Wren6991/PiBook/Readme.md

PiBook
======

Mini Raspberry Pi Compute Module-based laptop.

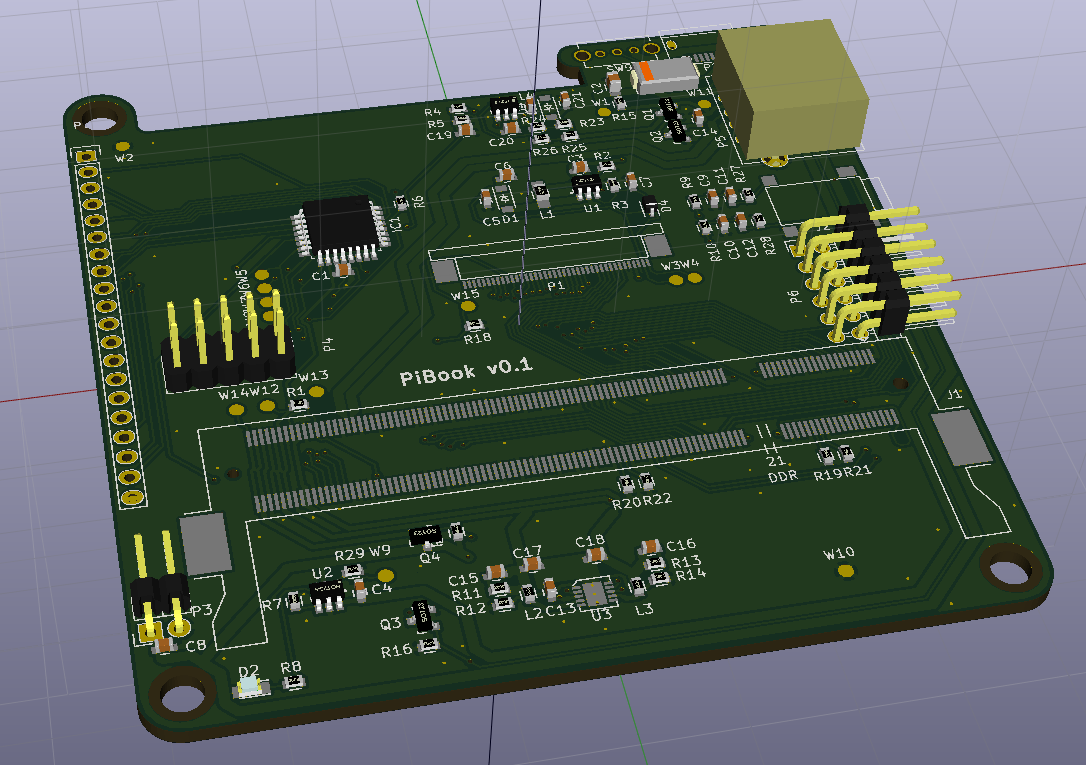
[picture p1: img/board_3d_view.png]


Unless stated otherwise (e.g. the contents of datasheets/) the contents of this repository is distributed under the revised BSD licence; see LICENSE.txt.
