Wren6991/PiBook/case/001.JPG

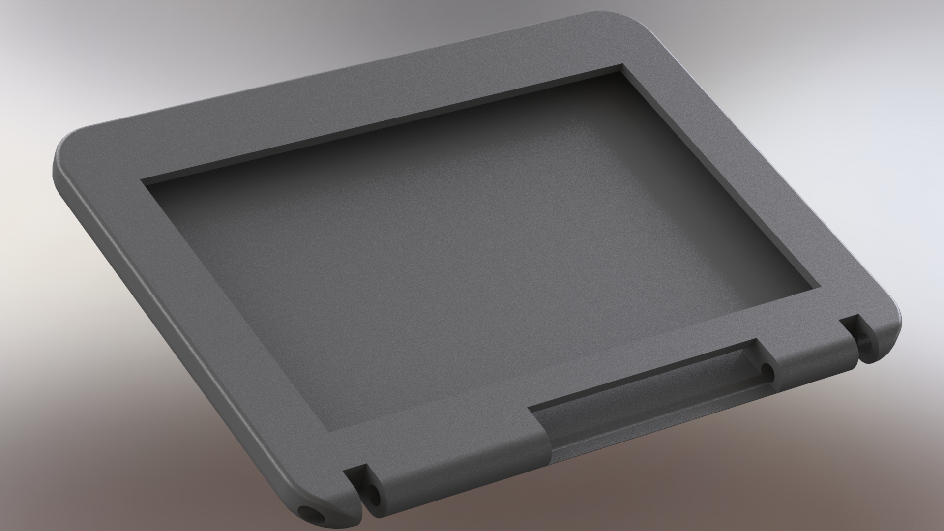
case/001.JPG
