Wren6991/PiBook/case/002.JPG

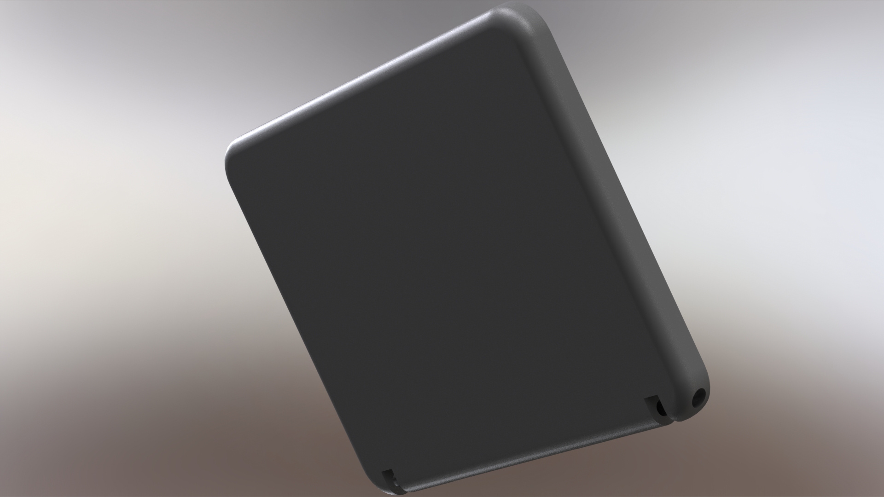
case/002.JPG
