Wren6991/PiBook/case/003.JPG

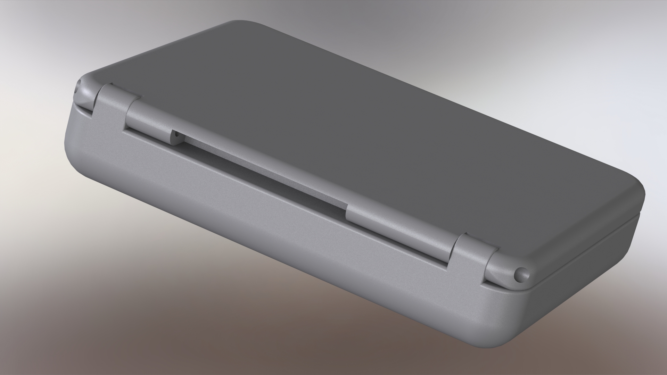
case/003.JPG
