Wren6991/PiBook/case/004.JPG

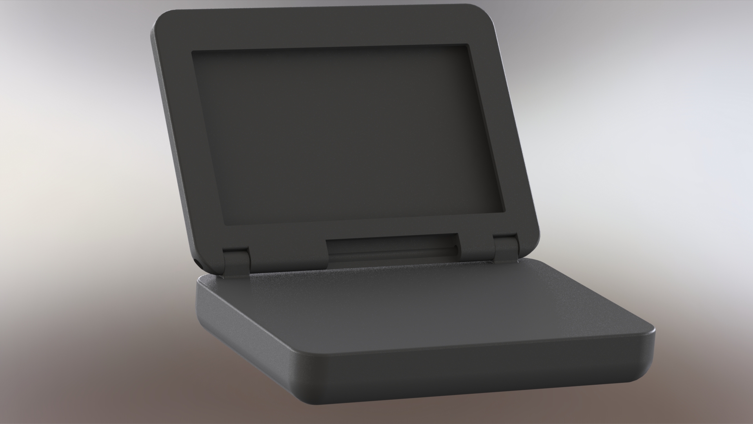
case/004.JPG
