Wren6991/PiBook/case/005.JPG

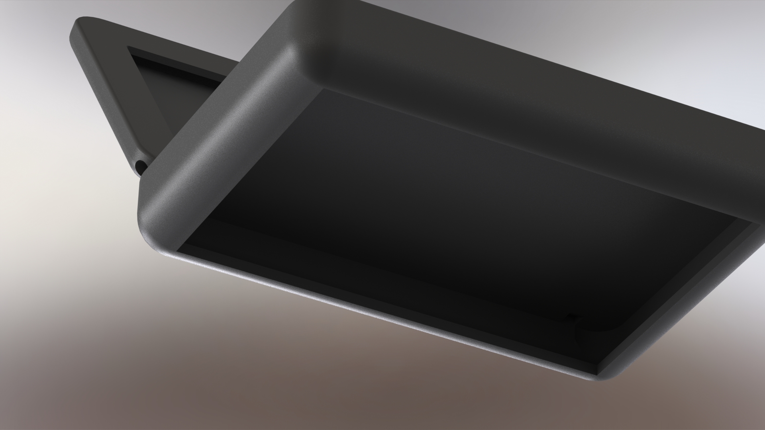
case/005.JPG
