Wren6991/PiBook/datasheets/DPI Connection table.png

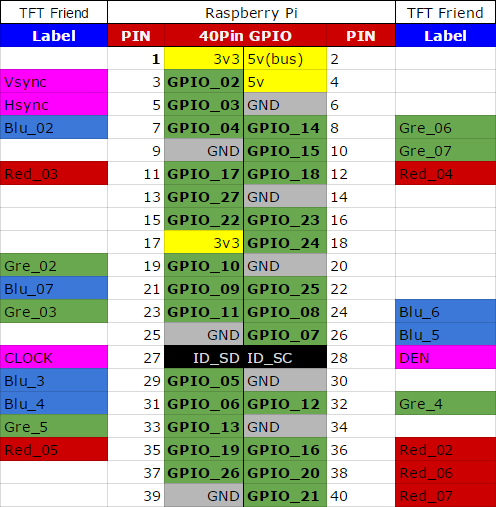
datasheets/DPI Connection table.png
