Wren6991/PiBook/pibook.pdf

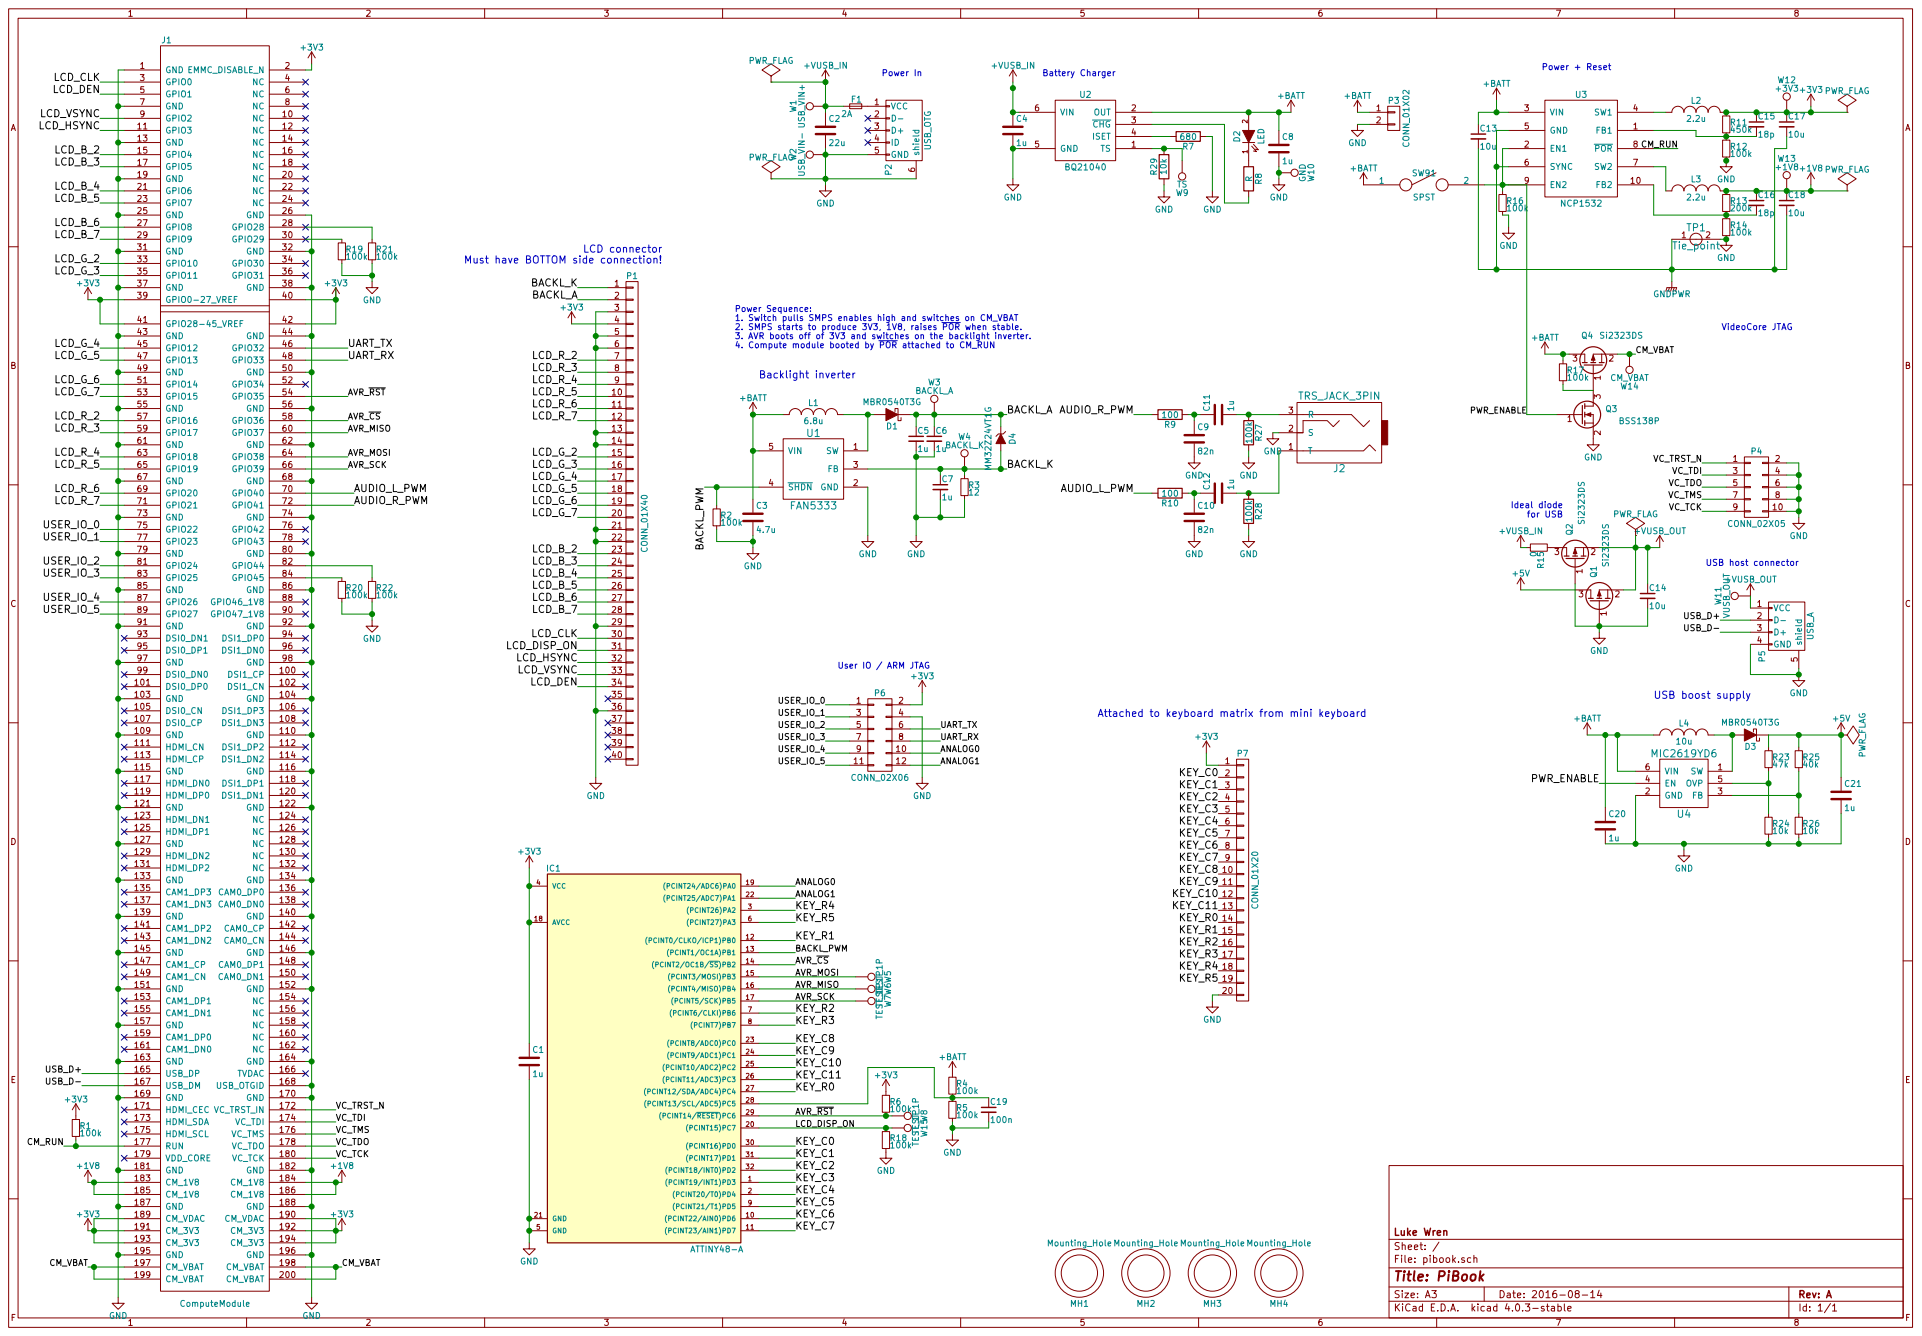
[picture p8: page 1]

Must have BOTTOM side connection!

1. Switch pulls SMPS enables high and switches on CM_VBAT
2. SMPS starts to produce 3V3, 1V8, raises POR when stable.
3. AVR boots off of 3V3 and switches on the backlight inverter.
4. Compute module booted by POR attached to CM_RUN

File: pibook.sch Sheet: / Luke Wren
