Wren6991/PiBook/pibook.kicad_pcb

## KiCad design pibook.kicad_pcb (2016-11-02)

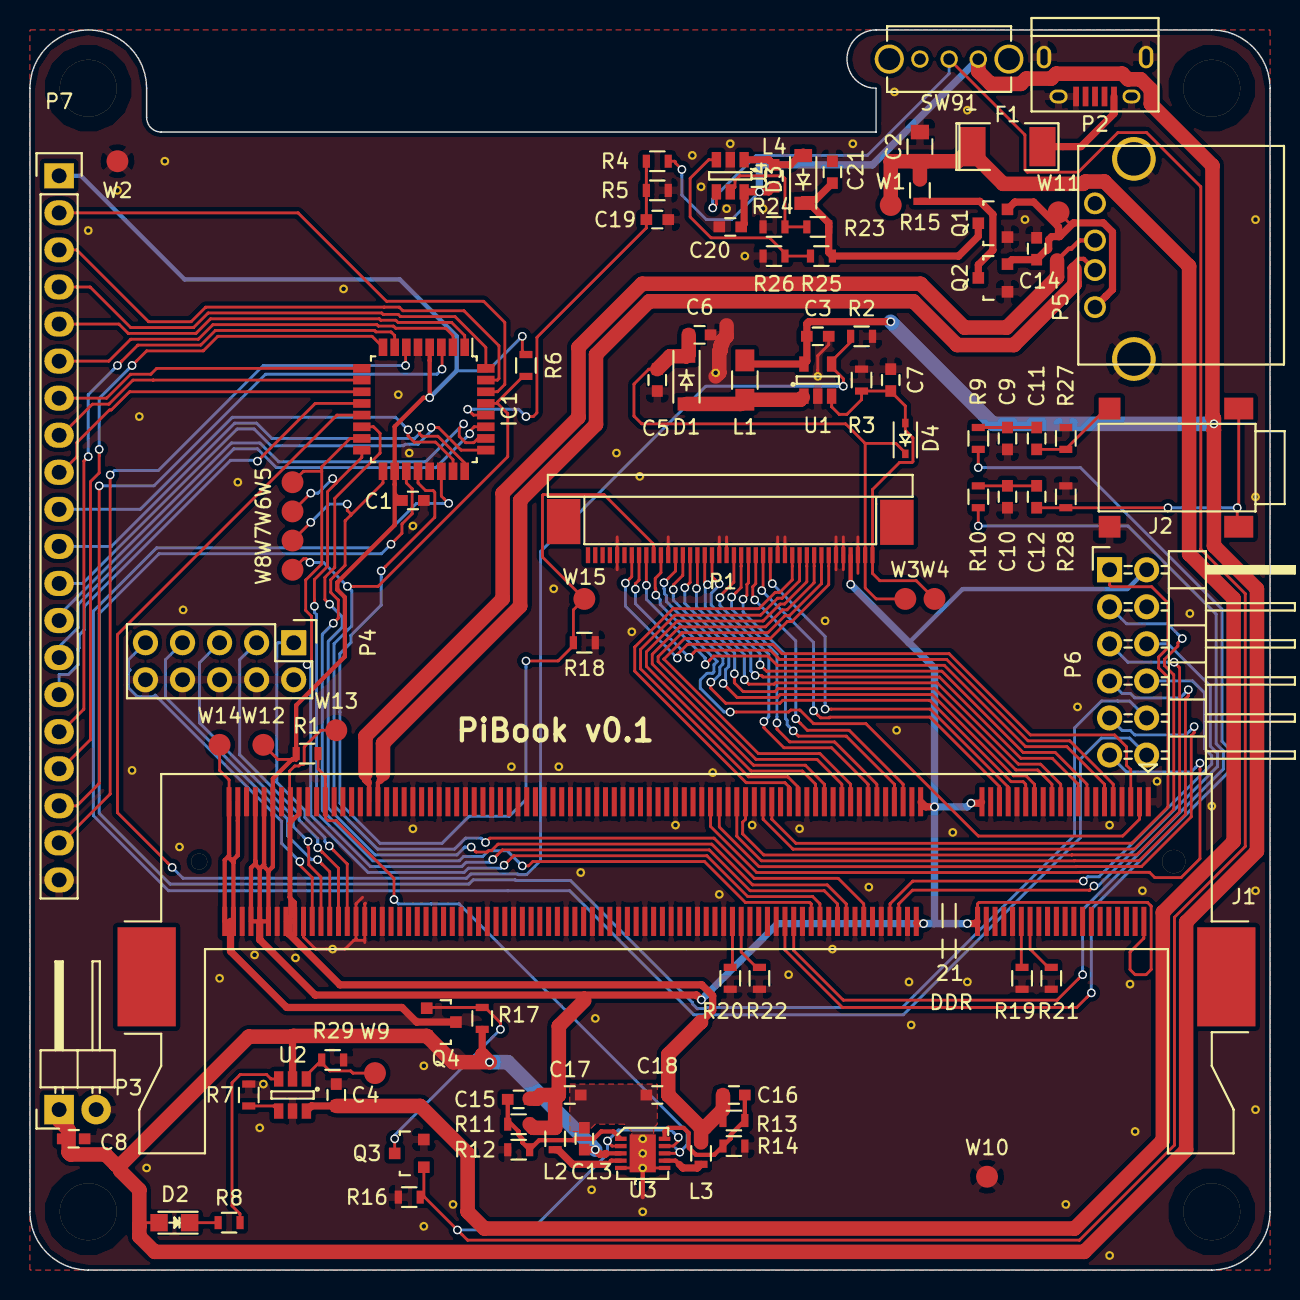
[picture p9: board pibook.kicad_pcb from above]

Board: 2 copper layers, 85.0 x 85.0 mm, 98 parts (0 on the bottom side), 103 nets.

Parts:
C1, C4, C5, C6, C7, C8, C11, C12, C20, C21: 1u; C_0603
C2: 22u; C_0805
C3: 4.7u; C_0603
C9, C10: 82n; C_0603
C13, C14, C17, C18: 10u; C_0603
C15, C16: 18p; C_0603
C19: 100n; C_0603
D1, D3: MBR0540T3G; SOD-123
D2: LED; LED_0805
D4: MM32Z24VT1G; SOD-323
F1: 2A; SMD-2010_Pol
IC1: ATTINY48-A; LQFP-32_7x7mm_Pitch0.8mm
J1: ComputeModule; Socket_SODIMM_DDR1-2_TE_1612618
J2: TRS_JACK_3PIN; TRS_3_SMD
L1: 6.8u; R_0805_HandSoldering
L2, L3: 2.2u; R_0603
L4: 10u; C_0603
MH1, MH2, MH3, MH4: Mounting_Hole; Mounting_hole_M3.5
P1: CONN_01X40; FPC40_BOTTOM
P2: USB_OTG; USB_Micro-B
P3: CONN_01X02; Pin_Header_Angled_1x02
P4: CONN_02X05; Pin_Header_Straight_2x05
P5: USB_A
P6: CONN_02X06; Pin_Header_Angled_2x06
P7: CONN_01X20; Pin_Header_Straight_1x20
Q1, Q2, Q4: Si2323DS; SOT-23
Q3: BSS138P; SOT-23
R1, R2, R4, R5, R6, R12, R14, R16, R17, R18, R19, R20, R21, R22, R27, R28: 100k; R_0603
R3: 12; R_0603
R7: 680; R_0603
R8: R; R_0603
R9, R10: 100; R_0603
R11: 450k; R_0603
R13: 200k; R_0603
R15: 0; R_0603
R23: 47k; R_0603
R24, R26, R29: 10k; R_0603
R25: 40k; R_0603
SW91: SPST; SPDT_SLIDE_SWITCH
TP1: Tie_point; tiepoint-0.3
U1: FAN5333; SOT-23-5
U2: BQ21040; SOT-23-6
U3: NCP1532; UDFN-10
U4: MIC2619YD6; SOT-23-6
W1: USB_VIN+; Measurement_Point_Round-SMD-Pad_Small
W2: USB_VIN-; Measurement_Point_Round-SMD-Pad_Small
W3: BACKL_A; Measurement_Point_Round-SMD-Pad_Small
W4: BACKL_K; Measurement_Point_Round-SMD-Pad_Small
W5, W6, W7, W8, W15: TEST_1P; Measurement_Point_Round-SMD-Pad_Small
W9: TS; Measurement_Point_Round-SMD-Pad_Small
W10: GND; Measurement_Point_Round-SMD-Pad_Small
W11: VUSB_OUT; Measurement_Point_Round-SMD-Pad_Small
W12: +3V3; Measurement_Point_Round-SMD-Pad_Small
W13: +1V8; Measurement_Point_Round-SMD-Pad_Small
W14: CM_VBAT; Measurement_Point_Round-SMD-Pad_Small

Connections:
+1V8: C16.1, C18.1, J1.183, J1.184, J1.185, J1.186, L3.2, R13.1, W13.1
+3V3: C1.1, C15.1, C17.1, IC1.4, IC1.18, J1.2, J1.39, J1.40, J1.41, J1.42, J1.189, J1.190, J1.191, J1.192, J1.193, J1.194, L2.2, P1.4, P6.2, P7.1, R1.1, R6.1, R11.1, W12.1
+5V: C21.1, D3.1, Q1.3, R23.1, R25.1
+BATT: C3.1, C8.1, C13.1, C20.1, D2.2, L1.1, L4.1, P3.1, Q4.2, R4.1, R17.1, SW91.1, U1.5, U2.2, U3.3, U4.6
+VUSB_IN: C2.1, C4.1, F1.1, R15.2, U2.6, W1.1
+VUSB_OUT: C14.1, P5.1, Q1.2, Q2.2, W11.1
/ANALOG0: IC1.19, P6.10
/ANALOG1: IC1.22, P6.12
/AUDIO_L_PWM: J1.70, R10.2
/AUDIO_R_PWM: J1.72, R9.2
/AVR_MISO: IC1.16, J1.60, W6.1
/AVR_MOSI: IC1.15, J1.64, W5.1
/AVR_SCK: IC1.17, J1.66, W7.1
/AVR_~CS: IC1.14, J1.58
/AVR_~RST: IC1.29, J1.54, R6.2, W8.1
/BACKL_A: C5.1, C6.1, D1.1, D4.1, P1.2, W3.1
/BACKL_K: C7.1, D4.2, P1.1, R3.1, U1.3, W4.1
/BACKL_PWM: IC1.13, R2.1, U1.4
/CM_RUN: J1.177, R1.2, U3.8
/CM_VBAT: J1.197, J1.198, J1.199, J1.200, Q4.3, W14.1
/KEY_C0: IC1.30, P7.2
/KEY_C1: IC1.31, P7.3
/KEY_C2: IC1.32, P7.4
/KEY_C3: IC1.1, P7.5
/KEY_C4: IC1.2, P7.6
/KEY_C5: IC1.9, P7.7
/KEY_C6: IC1.10, P7.8
/KEY_C7: IC1.11, P7.9
/KEY_C8: IC1.23, P7.10
/KEY_C9: IC1.24, P7.11
/KEY_C10: IC1.25, P7.12
/KEY_C11: IC1.26, P7.13
/KEY_R0: IC1.27, P7.14
/KEY_R1: IC1.12, P7.15
/KEY_R2: IC1.7, P7.16
/KEY_R3: IC1.8, P7.17
/KEY_R4: IC1.3, P7.18
/KEY_R5: IC1.6, P7.19
/LCD_B_2: J1.15, P1.23
/LCD_B_3: J1.17, P1.24
/LCD_B_4: J1.21, P1.25
/LCD_B_5: J1.23, P1.26
/LCD_B_6: J1.27, P1.27
/LCD_B_7: J1.29, P1.28
/LCD_CLK: J1.3, P1.30
/LCD_DEN: J1.5, P1.34
/LCD_DISP_ON: IC1.20, P1.31, R18.1, W15.1
/LCD_G_2: J1.33, P1.15
/LCD_G_3: J1.35, P1.16
/LCD_G_4: J1.45, P1.17
/LCD_G_5: J1.47, P1.18
/LCD_G_6: J1.51, P1.19
/LCD_G_7: J1.53, P1.20
/LCD_HSYNC: J1.11, P1.32
/LCD_R_2: J1.57, P1.7
/LCD_R_3: J1.59, P1.8
/LCD_R_4: J1.63, P1.9
/LCD_R_5: J1.65, P1.10
/LCD_R_6: J1.69, P1.11
/LCD_R_7: J1.71, P1.12
/LCD_VSYNC: J1.9, P1.33
/PWR_ENABLE: Q3.1, R16.1, SW91.2, U3.2, U3.9, U4.4
/UART_RX: J1.48, P6.8
/UART_TX: J1.46, P6.6
/USB_D+: J1.165, P5.2
/USB_D-: J1.167, P5.3
/USER_IO_0: J1.75, P6.1
/USER_IO_1: J1.77, P6.3
/USER_IO_2: J1.81, P6.5
/USER_IO_3: J1.83, P6.7
/USER_IO_4: J1.87, P6.9
/USER_IO_5: J1.89, P6.11
/VC_TCK: J1.180, P4.9
/VC_TDI: J1.174, P4.3
/VC_TDO: J1.178, P4.5
/VC_TMS: J1.176, P4.7
/VC_TRST_N: J1.172, P4.1
GND: C1.2, C2.2, C3.2, C4.2, C5.2, C6.2, C7.2, C8.2, C9.2, C10.2, C14.2, C19.2, C20.2, C21.2, IC1.5, IC1.21, J1.1, J1.7, J1.13, J1.19, J1.25, J1.26, J1.31, J1.32, J1.37, J1.38, J1.43, J1.44, J1.49, J1.50, J1.55, J1.56, J1.61, J1.62, J1.67, J1.68, J1.73, J1.74, J1.79, J1.80, J1.85, J1.86, J1.91, J1.92, J1.97, J1.98, J1.103, J1.104, J1.109, J1.110, J1.115, J1.116, J1.121, J1.122, J1.127, J1.133, J1.134, J1.139, J1.140, J1.145, J1.146, J1.151, J1.152, J1.157, J1.163, J1.164, J1.168, J1.169, J1.170, J1.181, J1.182, J1.187, J1.188, J1.195, J1.196, J2.2, P1.3, P1.5, P1.6, P1.13, P1.14, P1.21, P1.22, P1.29, P1.36, P2.5, P2.6, P3.2, P4.2, P4.4, P4.6, P4.8, P4.10, P5.4, P5.5, P6.4, P7.20, Q1.1, Q2.1, Q3.2, R2.2, R3.2, R5.2, R7.1, R12.2, R14.2, R16.2, R18.2, R19.2, R20.2, R21.2, R22.2, R24.2, R26.2, R27.2, R28.2, R29.1, TP1.2, U1.2, U2.5, U4.2, W2.1, W10.1
GNDPWR: C13.2, C17.2, C18.2, TP1.1, U3.5, U3.6
unnamed: C10.1, C12.1, R10.1
unnamed: C9.1, C11.1, R9.1
unnamed: C11.2, J2.3, R27.1
unnamed: C12.2, J2.1, R28.1
unnamed: C15.2, R11.2, R12.1, U3.1
unnamed: C16.2, R13.2, R14.1, U3.10
unnamed: C19.1, IC1.28, R4.2, R5.1
unnamed: D1.2, L1.2, U1.1
unnamed: D2.1, R8.1
unnamed: D3.2, L4.2, U4.1
unnamed: F1.2, P2.1
unnamed: J1.28, R21.1
unnamed: J1.30, R19.1
unnamed: J1.82, R22.1
unnamed: J1.84, R20.1
unnamed: L2.1, U3.4
unnamed: L3.1, U3.7
unnamed: Q2.3, R15.1
unnamed: Q3.3, Q4.1, R17.2
unnamed: R7.2, U2.4
unnamed: R8.2, U2.3
unnamed: R23.2, R24.1, U4.5
unnamed: R25.2, R26.1, U4.3
unnamed: R29.2, U2.1, W9.1
