Wren6991/PiBook/datasheets/lcd_breakout.brd

## EAGLE design datasheets/lcd_breakout.brd (2016-08-14)

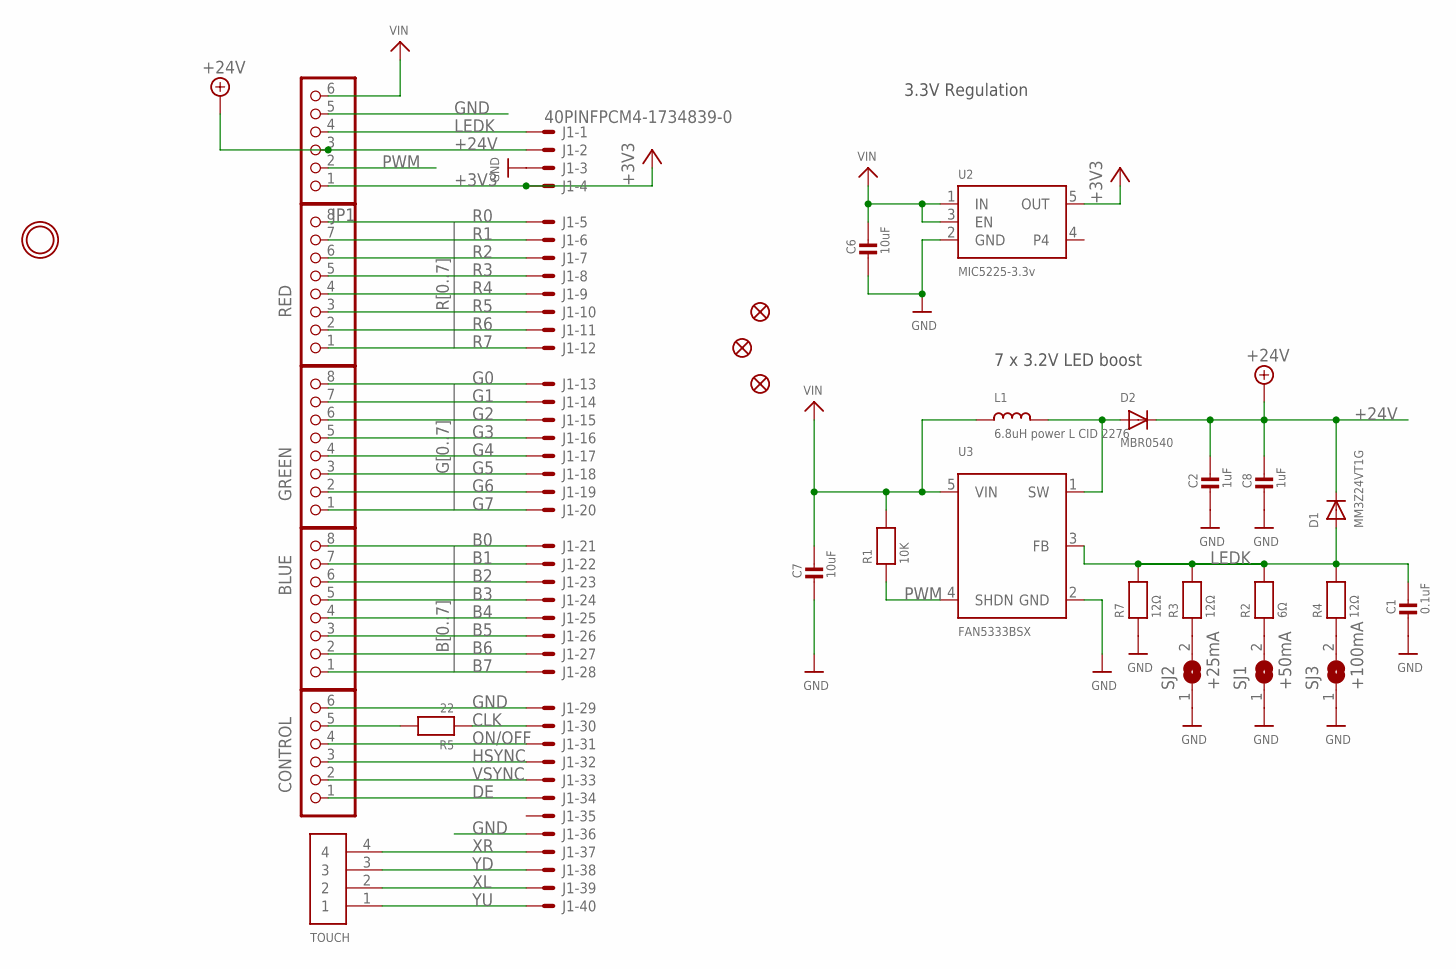
[picture p10: schematic lcd_breakout.sch]

Parts:
BLUE: PINHD-1X8BIG; 1X08-BIG
C1: 0.1uF; _0805MP
C2, C8: 1uF; _0805MP
C6, C7: 10uF; _0805MP
CONTROL: PINHD-1X6B; 1X06-BIG
D1: MM3Z24VT1G; SMADIODE
D2: MBR0540; SOD-123
FID1, FID2, FID3: FIDUCIAL""; FIDUCIAL_1MM
GREEN: PINHD-1X8BIG; 1X08-BIG
J1: 40PINFPCM4-1734839-0; 4-1734839-0
JP1: PINHD-1X6B; 1X06-BIG
L1: 6.8uH power L CID 2276; INDUCTOR_5X5MM_NR5040_NOTHERMALS
R1: 10K; _0805MP
R2: 6Ω; _0805MP
R3, R4, R7: 12Ω; _0805MP
R5: 22; _0805MP
RED: PINHD-1X8BIG; 1X08-BIG
SJ1: +50mA; SOLDERJUMPER_ARROW_NOPASTE
SJ2: +25mA; SOLDERJUMPER_ARROW_NOPASTE
SJ3: +100mA; SOLDERJUMPER_ARROW_NOPASTE
TOUCH: 1X4-BIG; 1X04-BIG
U2: MIC5225-3.3v; SOT23-5
U3: FAN5333BSX; SOT23-5@1
U$7: MOUNTINGHOLE2.5; MOUNTINGHOLE_2.5_PLATED

Connections:
+3V3: J1.4 (MS), JP1.1, U2.5 (OUT)
+24V: C2.1, C8.1, D1.C, D2.C, J1.2 (MS), JP1.3
B0: BLUE.8, J1.21 (MS)
B1: BLUE.7, J1.22 (MS)
B2: BLUE.6, J1.23 (MS)
B3: BLUE.5, J1.24 (MS)
B4: BLUE.4, J1.25 (MS)
B5: BLUE.3, J1.26 (MS)
B6: BLUE.2, J1.27 (MS)
B7: BLUE.1, J1.28 (MS)
CLK: J1.30 (MS), R5.1
DE: CONTROL.1, J1.34 (MS)
G0: GREEN.8, J1.13 (MS)
G1: GREEN.7, J1.14 (MS)
G2: GREEN.6, J1.15 (MS)
G3: GREEN.5, J1.16 (MS)
G4: GREEN.4, J1.17 (MS)
G5: GREEN.3, J1.18 (MS)
G6: GREEN.2, J1.19 (MS)
G7: GREEN.1, J1.20 (MS)
GND: C1.2, C2.2, C6.2, C7.2, C8.2, CONTROL.6, J1.3 (MS), J1.29 (MS), J1.36 (MS), JP1.5, R7.1, SJ1.1, SJ2.1, SJ3.1, U2.2 (GND), U3.2 (GND)
HSYNC: CONTROL.3, J1.32 (MS)
LEDK: C1.1, D1.A, J1.1 (MSV), JP1.4, R2.2, R3.2, R4.2, R7.2, U3.3 (FB)
unnamed: R2.1, SJ1.2
unnamed: R3.1, SJ2.2
unnamed: R4.1, SJ3.2
unnamed: CONTROL.5, R5.2
unnamed: D2.A, L1.P$2 (2), U3.1 (SW)
ON/OFF: CONTROL.4, J1.31 (MS)
PWM: JP1.2, R1.1, U3.4 (SHDN)
R0: J1.5 (MS), RED.8
R1: J1.6 (MS), RED.7
R2: J1.7 (MS), RED.6
R3: J1.8 (MS), RED.5
R4: J1.9 (MS), RED.4
R5: J1.10 (MS), RED.3
R6: J1.11 (MS), RED.2
R7: J1.12 (MS), RED.1
VIN: C6.1, C7.1, JP1.6, L1.P$1 (1), R1.2, U2.1 (IN), U2.3 (EN), U3.5 (VIN)
VSYNC: CONTROL.2, J1.33 (MS)
XL: J1.39 (MS), TOUCH.2
XR: J1.37 (MS), TOUCH.4
YD: J1.38 (MS), TOUCH.3
YU: J1.40 (MS), TOUCH.1

Notes on the sheet:
7 x 3.2V LED boost
3.3V Regulation

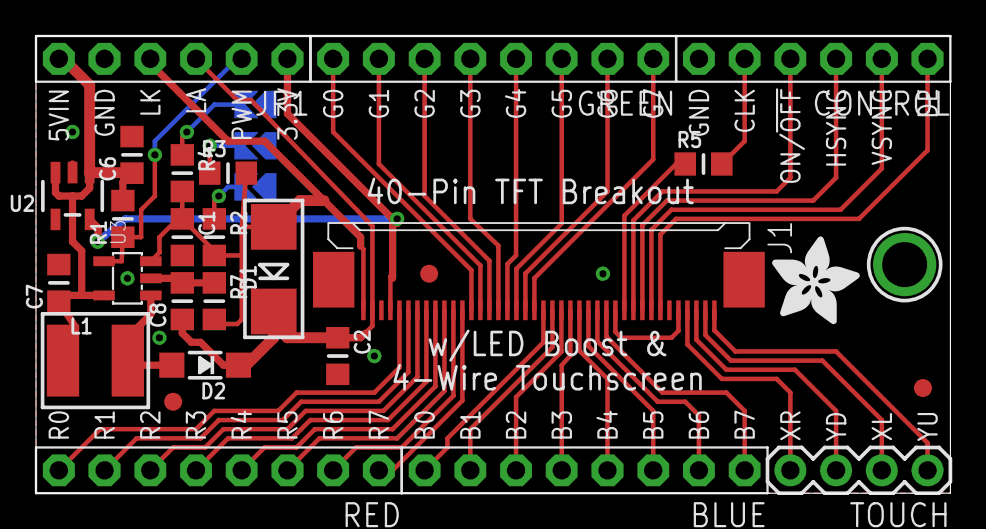
[picture p11: board lcd_breakout.brd from above]

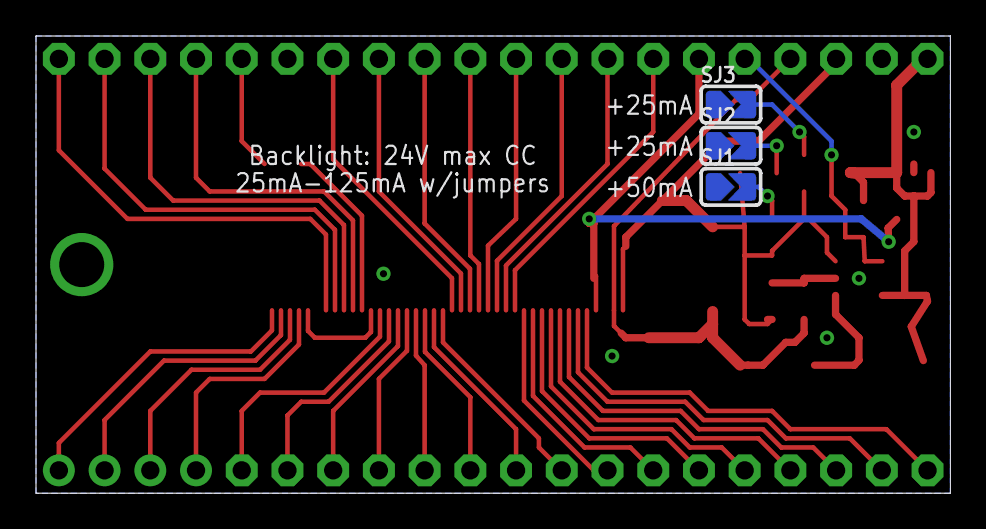
[picture p12: board lcd_breakout.brd from below]

Board: 2 copper layers, 50.8 x 25.4 mm, 31 parts (3 on the bottom side), 44 nets.

Other parts of the board:
U$15: ADAFRUIT_5MM
