Wren6991/PiBook/(commit log)

2016-08-14 Added switch footprint
2016-08-14 Components all on PCB
    [pibook.kicad_pcb, pibook.sch]
2016-08-15 Routed DPI bus
    [pibook.kicad_pcb]
2016-08-15 USB + some power routing
    [pibook.kicad_pcb, pibook.sch]
2016-08-15 New mechanical board layout
    [pibook.kicad_pcb, pibook.sch]
2016-08-16 Some more component placement
    [pibook.kicad_pcb, pibook.sch]
2016-08-16 All components placed
    [pibook.kicad_pcb]
2016-08-16 Some more power routing
    [pibook.kicad_pcb]
2016-08-16 AVR route out mostly done
    [pibook.kicad_pcb, pibook.sch]
2016-08-17 Rounded corners!
    [pibook.kicad_pcb]
2016-08-23 Added USB boost converter to schematic
    [pibook.sch]
2016-08-23 5V + some extra routing
    [pibook.kicad_pcb, pibook.sch]
2016-08-23 All signals routed (still fails DRC)
    [pibook.kicad_pcb]
2016-08-24 Corrected some DRC
    [pibook.kicad_pcb]
2016-08-26 Working on new switchmode layout
    [pibook.kicad_pcb, pibook.sch]
2016-08-26 Routed the buck supply
    [pibook.kicad_pcb, pibook.sch]
2016-08-26 Improved backlight and 5v power layout; added bleed resistor to audio filter
    [pibook.kicad_pcb, pibook.sch]
2016-08-26 Improved USB impedance - 97 ohms diff vs 120
    [pibook.kicad_pcb]
2016-08-26 fixed DRC, fixed component ref silkscreen
    [pibook.kicad_pcb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]
2016-08-27 Fixed up some things for production (putting NPTH in same drill file, tidied up some silk screen)
    [pibook.kicad_pcb, pibook.sch]
2016-08-27 Added gerbers/CAM files
    [pibook.GBL, pibook.GBO, pibook.GBP, pibook.GBS, pibook.GTL, pibook.GTO, pibook.GTP, pibook.GTS]
2016-08-27 Fixed some DRCs
    [pibook.GBL, pibook.GBO, pibook.GBP, pibook.GBS, pibook.GTL, pibook.GTO, pibook.GTP, pibook.GTS]
2016-08-27 Fixed DRCs and some grounding on the SODIMM
    [pibook.GBL, pibook.GBO, pibook.GBP, pibook.GBS, pibook.GTL, pibook.GTO, pibook.GTP, pibook.GTS]
2016-08-27 Update schematic PDF, add BOM
    [bom.csv, pibook.sch]
2016-08-30 Added some CAD images
2016-11-02 Corrected polarity of mosfet Q4 (switches CM_VBAT)
    [pibook.kicad_pcb, pibook.sch]
